nosolobots/robo-com/linus_v1/media/linus_v1_R2_pcb_parts.jpg

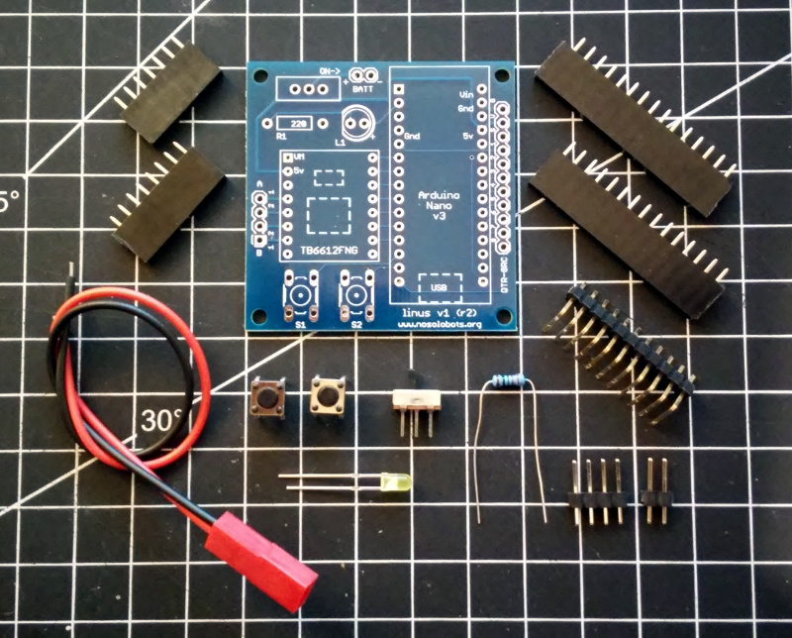
linus_v1/media/linus_v1_R2_pcb_parts.jpg
