nosolobots/robo-com/linus_v1/media/linus_v1_parts.jpg

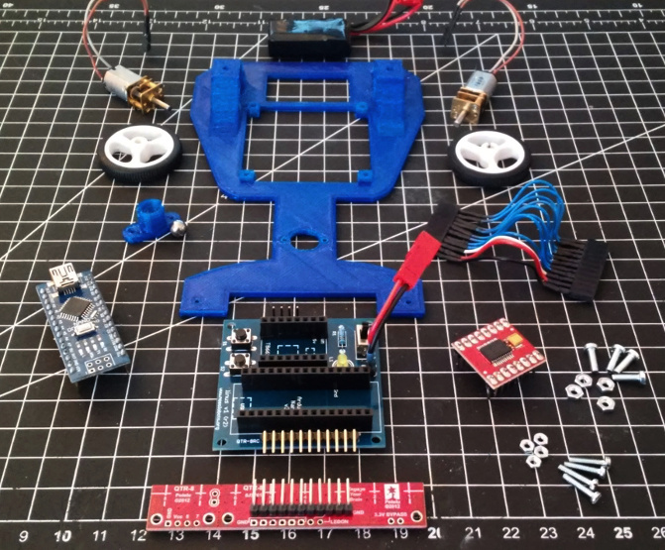
linus_v1/media/linus_v1_parts.jpg
