nosolobots/robo-com/README.md

# robo-com
 
The aim of the project is to create basic robotic kits for contests and competitions. 
 
Currently, there are two kits in progress: 
 
> **linus_v1** a *line follower* robot  
> **taurus_v1** a *mini sumo* robot
