nosolobots/robo-com/taurus_v1/README.md

### *taurus_v1* files repository

- **eagle/** PCB eagle files (sch brd)
- **fritzing/** Fritzing electric diagram
- **3D/** .STL .GCODE and SketchUp 3D model files
- **sketck/** Arduino sketch file
- **media/** Prototypes pictures&videos
