nosolobots/robo-com/taurus_v1/sketch/README.md

### *taurus_v1* Arduino sketches repository
