nosolobots/robo-com/taurus_v1/eagle/README.md

### *taurus_v1* PCB eagle files repository
