nosolobots/robo-com/linus_v1/doc/README.md

## linus_v1 docs repository

- Partlist
- PCB scheme
