nosolobots/robo-com/linus_v1/media/linus_v1_proto.jpg

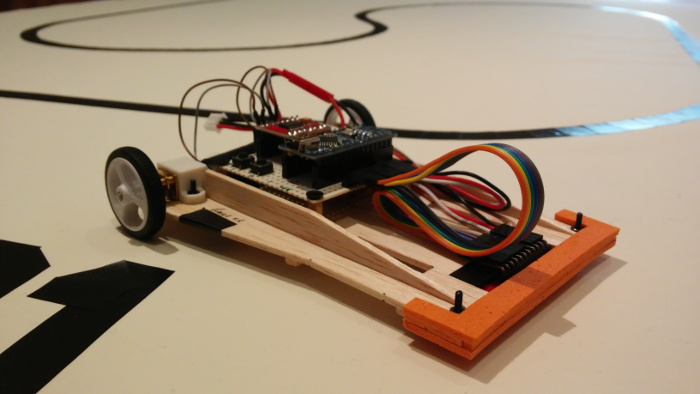
linus_v1/media/linus_v1_proto.jpg
