nosolobots/robo-com/linus_v1/media/linus_v1_R2_bb.jpg

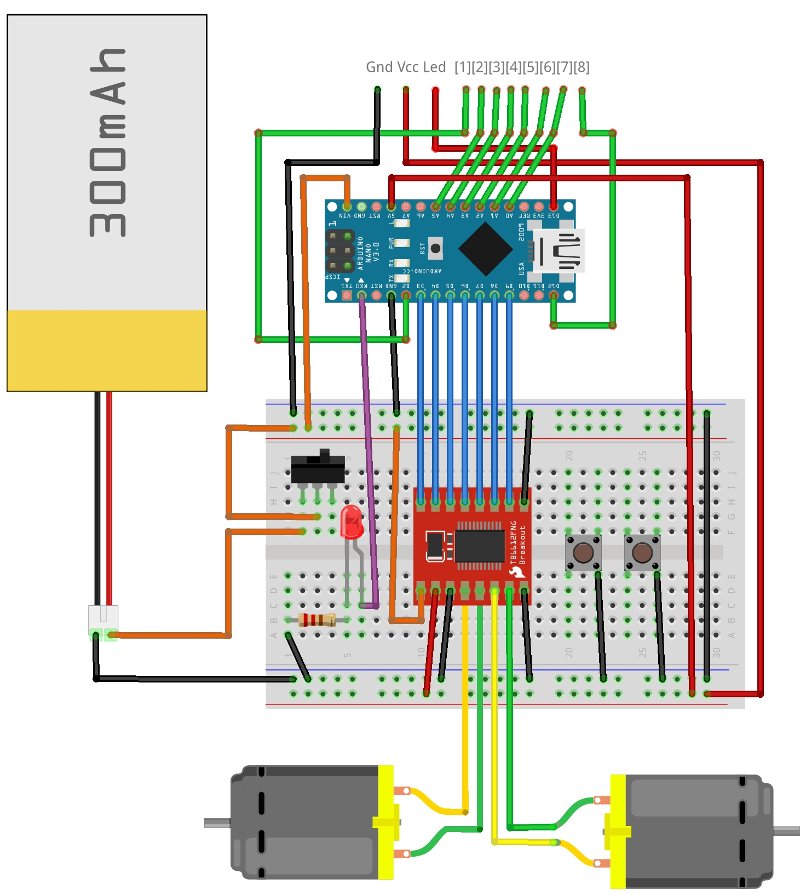
linus_v1/media/linus_v1_R2_bb.jpg
