nosolobots/robo-com/linus_v1/media/linus_v1_R2_EAGLE_brd.png

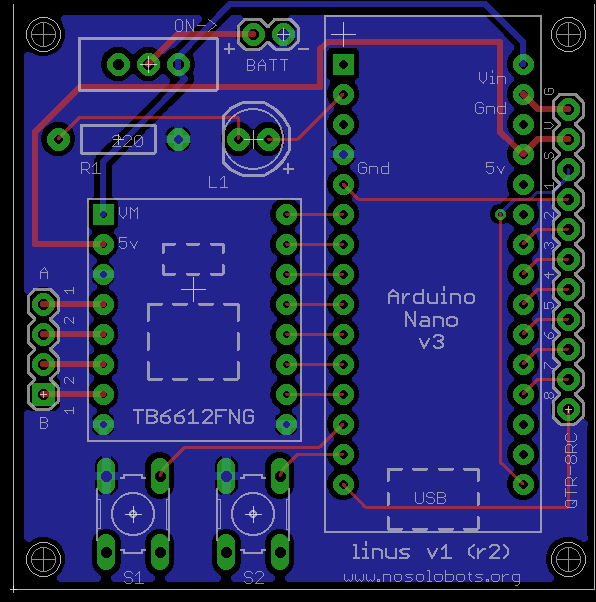
linus_v1/media/linus_v1_R2_EAGLE_brd.png
