nosolobots/robo-com/linus_v1/media/linus_v1_R2_EAGLE_sch.png

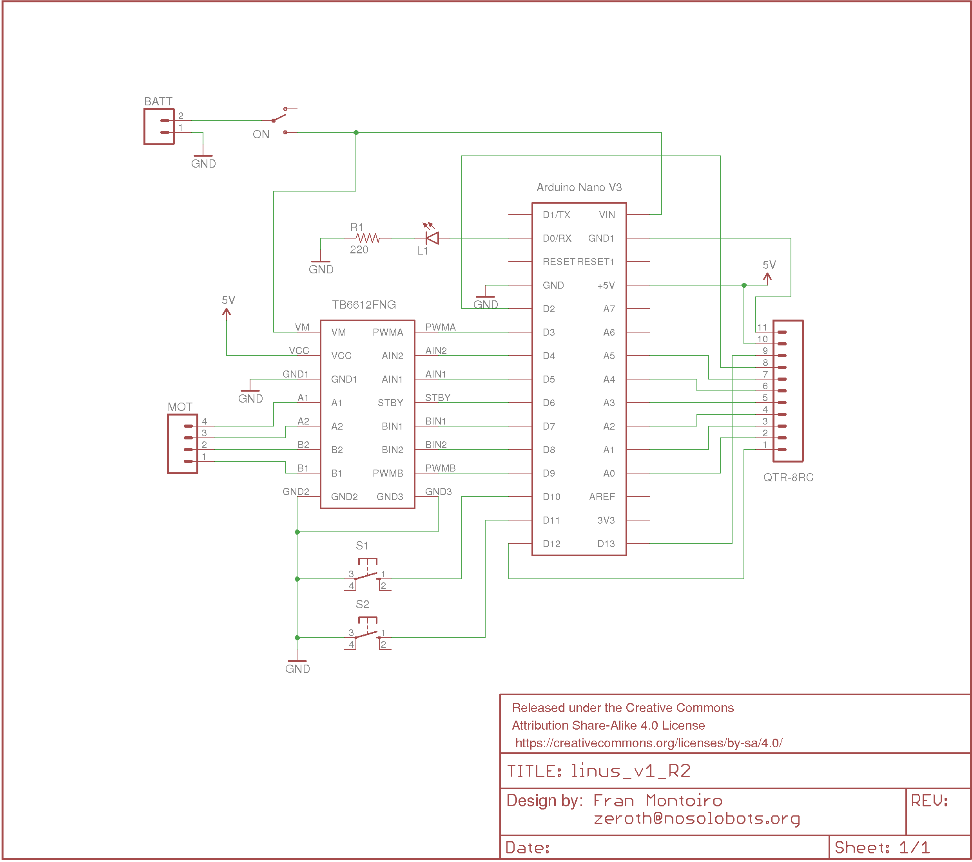
linus_v1/media/linus_v1_R2_EAGLE_sch.png
