nosolobots/robo-com/linus_v1/media/linus_v1_R2_placa.jpg

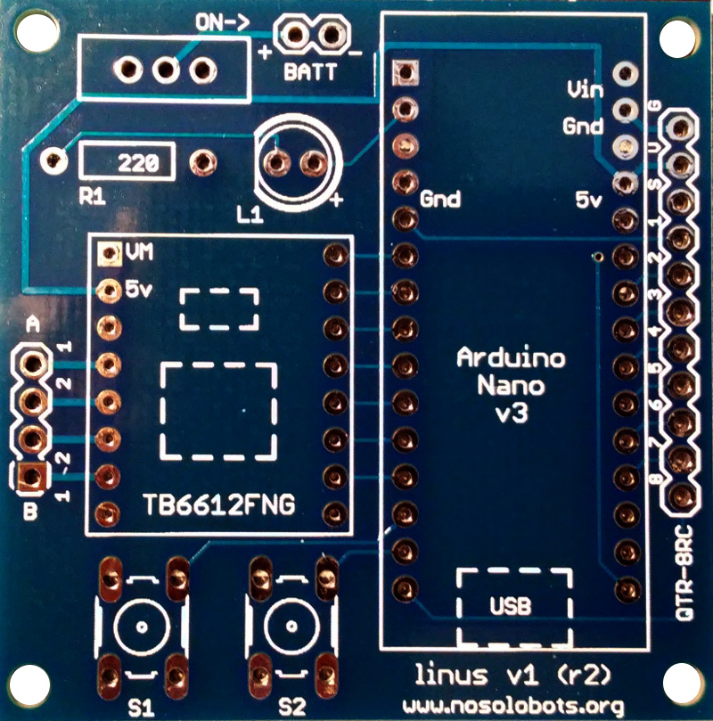
linus_v1/media/linus_v1_R2_placa.jpg
