nosolobots/robo-com/taurus_v1/media/taurus_v1.jpg

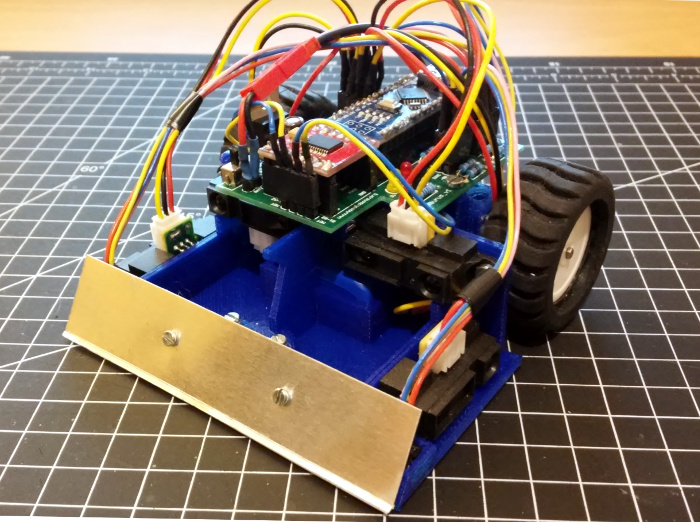
taurus_v1/media/taurus_v1.jpg
