nosolobots/robo-com/taurus_v1/media/taurus_v1_bb.jpg

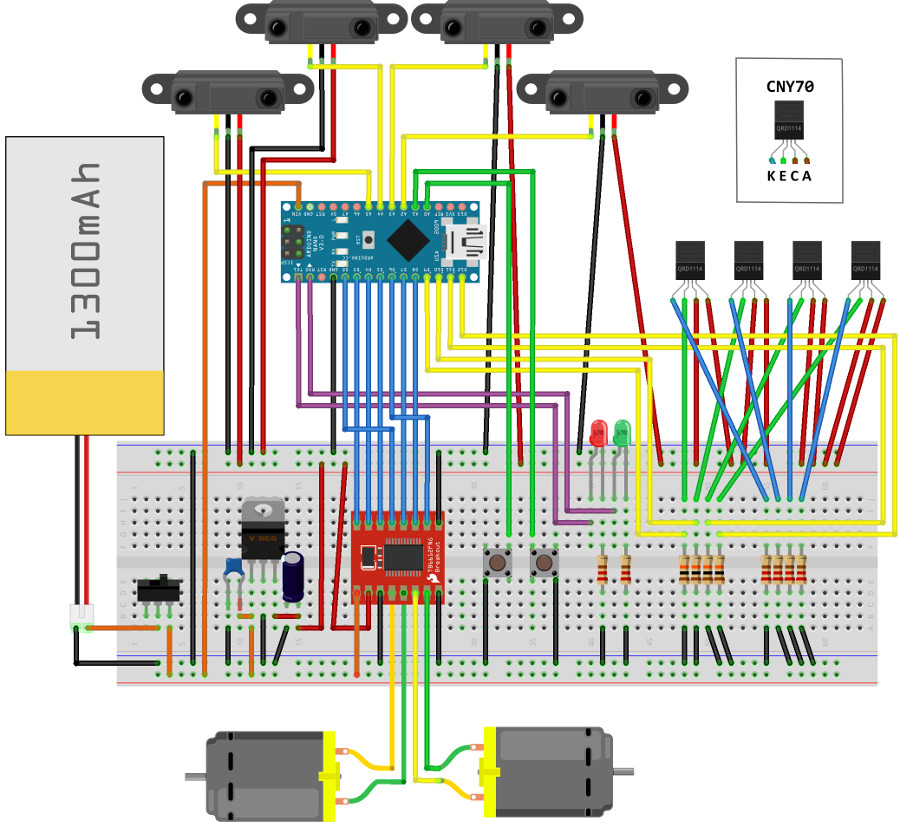
taurus_v1/media/taurus_v1_bb.jpg
