nosolobots/robo-com/taurus_v1/media/taurus_v1_brd.png

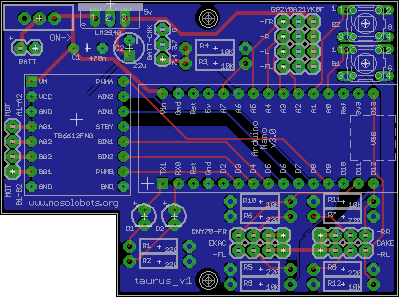
taurus_v1/media/taurus_v1_brd.png
