nosolobots/robo-com/taurus_v1/media/taurus_v1_chasis.jpg

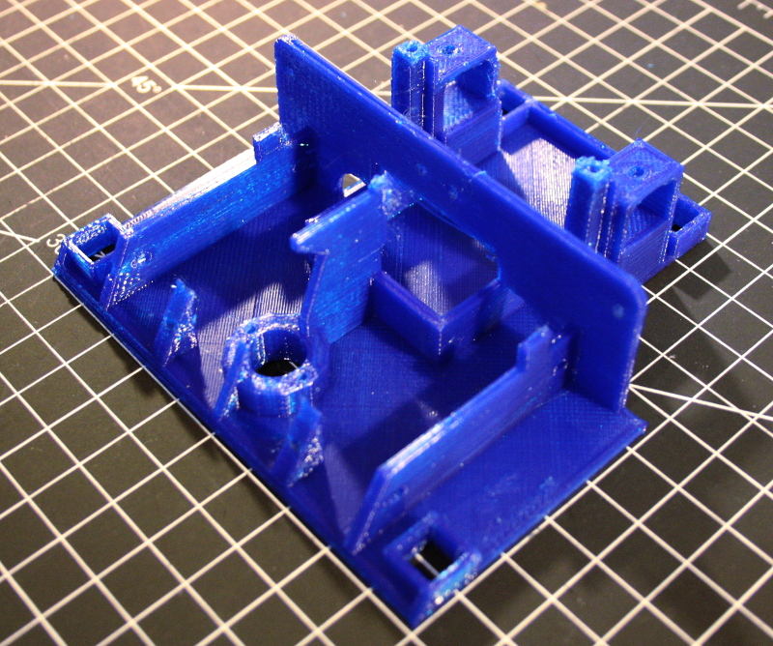
taurus_v1/media/taurus_v1_chasis.jpg
