nosolobots/robo-com/taurus_v1/media/taurus_v1_pcb.jpg

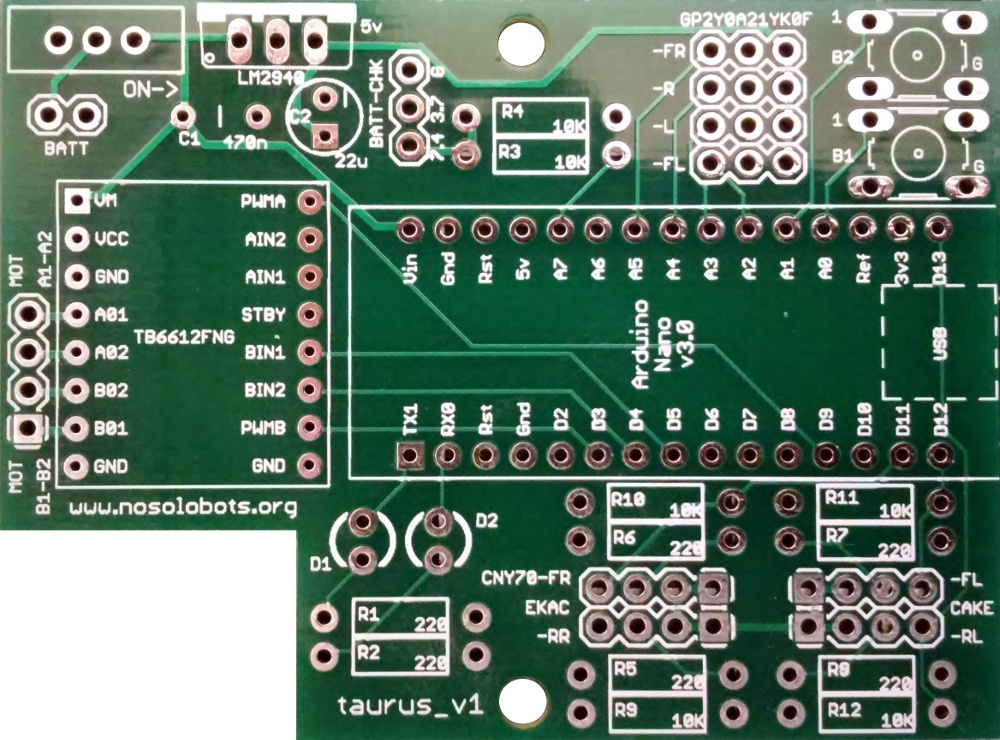
taurus_v1/media/taurus_v1_pcb.jpg
