nosolobots/robo-com/taurus_v1/media/taurus_v1_sch.png

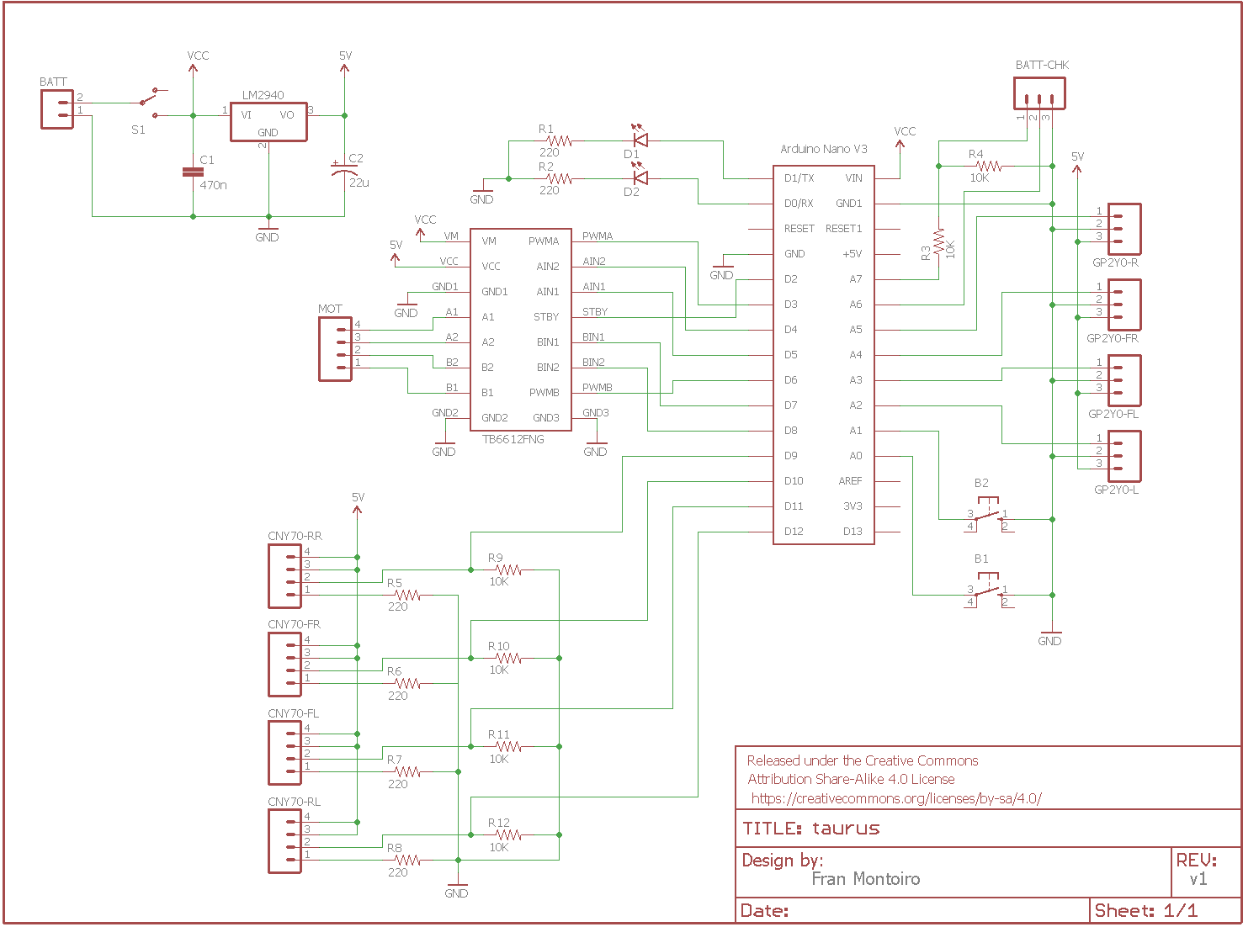
taurus_v1/media/taurus_v1_sch.png
