nosolobots/robo-com/linus_v1/3D/linus_v1_r4.stl

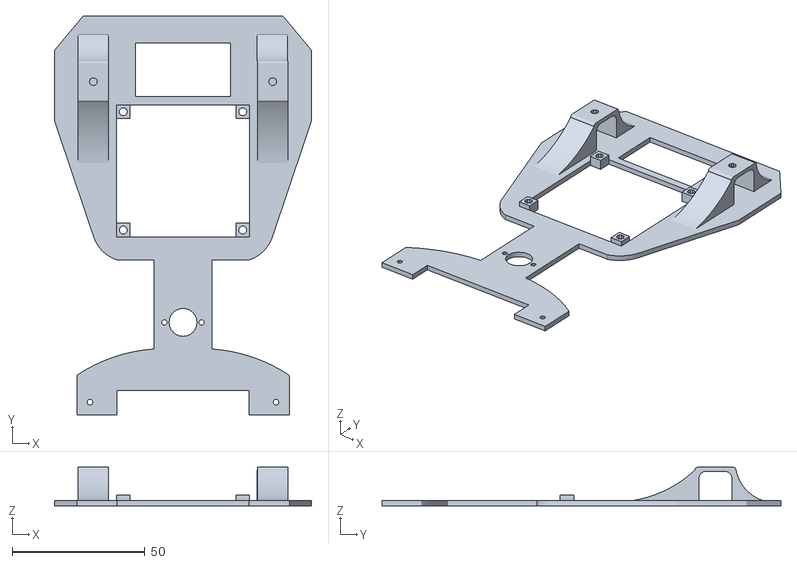
[picture p20: CAD file, 2017-03-30]
linus_v1/3D/linus_v1_r4.stl
96.7 x 150.1 x 14.5
