nosolobots/robo-com/taurus_v1/3D/taurus_v1_r2.stl

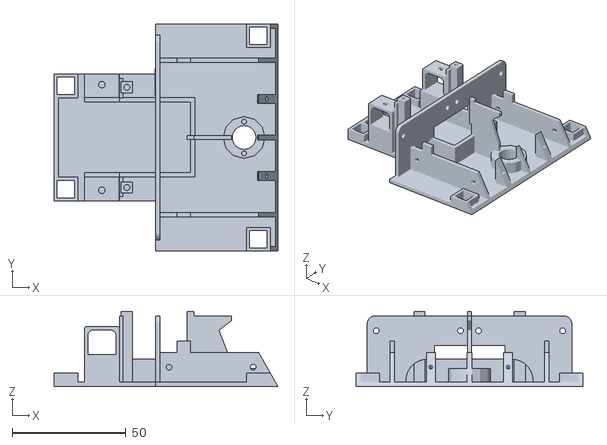
[picture p21: CAD file, 2017-03-30]
taurus_v1/3D/taurus_v1_r2.stl
98.4 x 99.9 x 33.0
