nosolobots/robo-com/taurus_v1/3D/BallCaster_6mm.stl

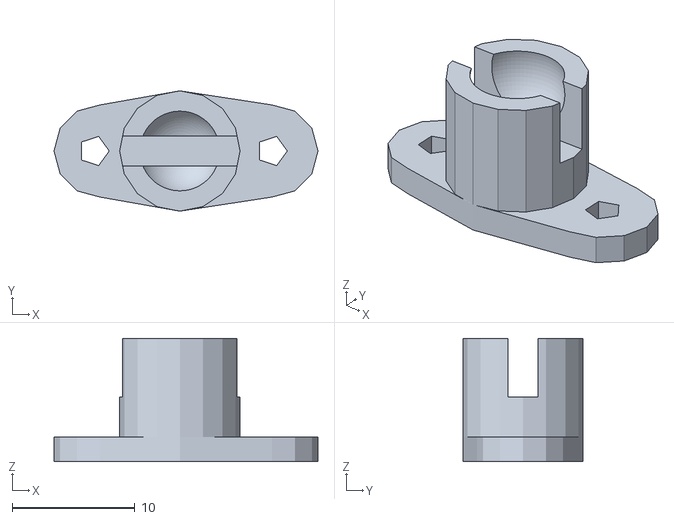
[picture p22: CAD file, 2017-03-30]
taurus_v1/3D/BallCaster_6mm.stl
21.5 x 9.80 x 10.0
