nosolobots/robo-com/(list of files, cad)

Other CAD files:
linus_v1/3D/linus_v1_r4.skp
taurus_v1/3D/taurus_v1_r2.skp
