nosolobots/robo-com/(list of files, drawings)

Other design files:
linus_v1/fritzing/linus_v1_R2.fzz
taurus_v1/fritzing/taurus_v1.fzz
