nosolobots/robo-com/taurus_v1/eagle/taurus_v1.brd

## EAGLE design taurus_v1/eagle/taurus_v1.brd (2017-03-30)

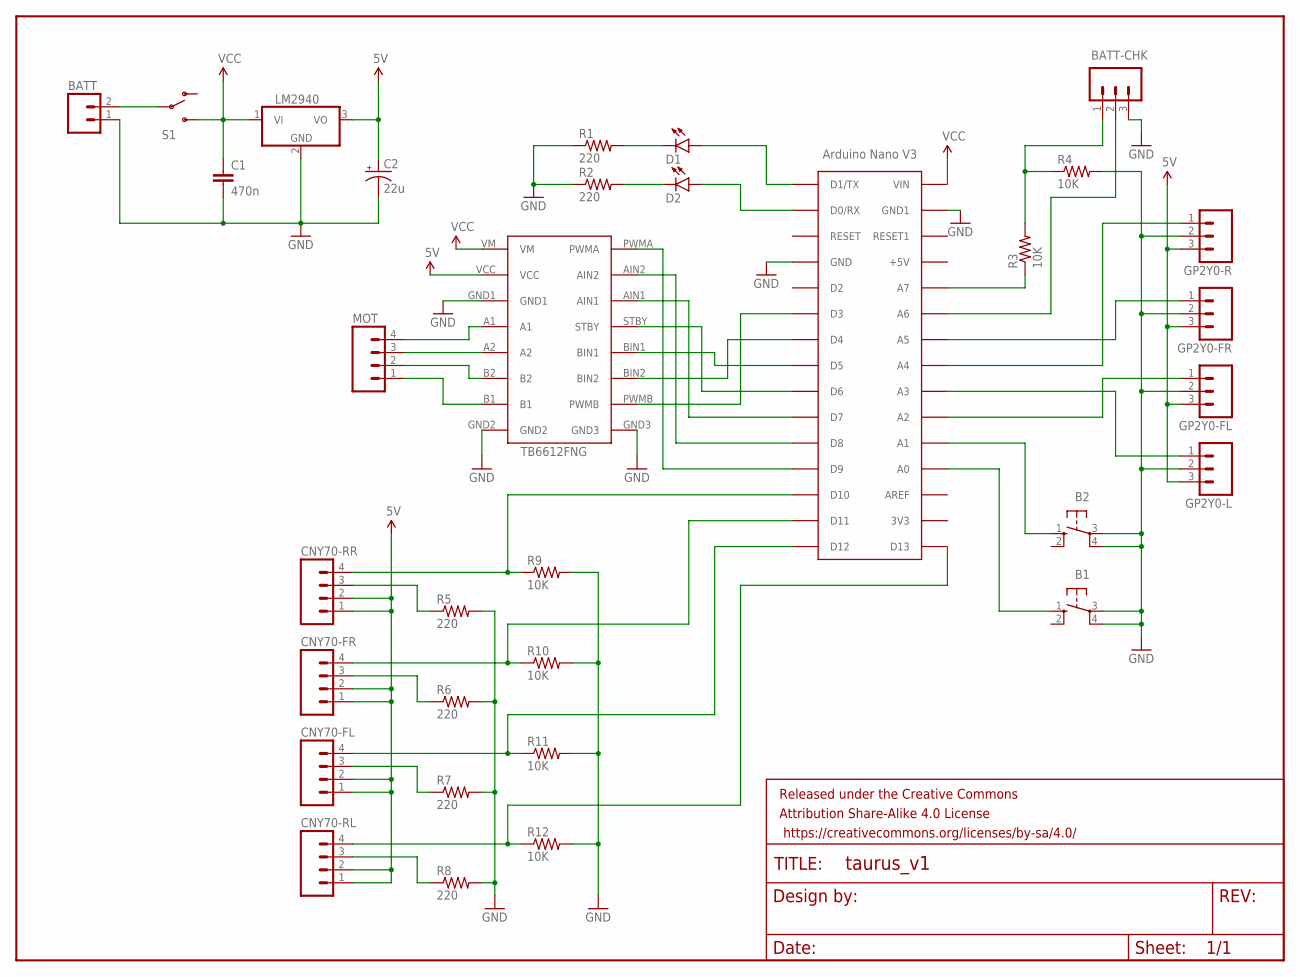
[picture p23: schematic taurus_v1.sch]

Parts:
B1, B2: 10-XX; B3F-10XX
BATT: M02PTH; 1X02
BATT-CHK: M03PTH; 1X03
C1: 470n; CAP-PTH-5MM
C2: 22u; CPOL-RADIAL-10UF-25V
CNY70-FL, CNY70-FR, CNY70-RL, CNY70-RR: M04PTH; 1X04
D1, D2: LED3MM
FRAME1: FRAME-LETTERNO_PACKAGE; DUMMY
GP2Y0-FL, GP2Y0-FR, GP2Y0-L, GP2Y0-R: M03PTH; 1X03
LM2940: 7805TV; TO220V
MOT: M04PTH; 1X04
R1, R2, R5, R6, R7, R8: 220; AXIAL-0.4
R3, R4, R9, R10, R11, R12: 10K; AXIAL-0.4
S1: SWITCH-SPDTPTH; SWITCH-SPDT
TB1: TB6612FNG
U$1: ARDUINONANO; PDIP-32

Connections:
5V: C2.1 (+), CNY70-FL.1, CNY70-FL.2, CNY70-FR.1, CNY70-FR.2, CNY70-RL.1, CNY70-RL.2, CNY70-RR.1, CNY70-RR.2, GP2Y0-FL.3, GP2Y0-FR.3, GP2Y0-L.3, GP2Y0-R.3, LM2940.3 (VO), TB1.VCC
GND: B1.3, B1.4 (P1), B2.3, B2.4 (P1), BATT.1, BATT-CHK.3, C1.2, C2.2 (-), GP2Y0-FL.2, GP2Y0-FR.2, GP2Y0-L.2, GP2Y0-R.2, LM2940.2 (GND), R1.P$1 (1), R2.P$1 (1), R4.P$2 (2), R5.P$2 (2), R6.P$2 (2), R7.P$2 (2), R8.P$2 (2), R9.P$2 (2), R10.P$2 (2), R11.P$2 (2), R12.P$2 (2), TB1.GND1, TB1.GND2, TB1.GND3, U$1.GND, U$1.GND1
unnamed: TB1.PWMA, U$1.D9
unnamed: TB1.AIN2, U$1.D8
unnamed: TB1.AIN1, U$1.D7
unnamed: TB1.STBY, U$1.D6
unnamed: TB1.BIN1, U$1.D5
unnamed: TB1.BIN2, U$1.D4
unnamed: TB1.PWMB, U$1.D3
unnamed: D1.K (C), R1.P$2 (2)
unnamed: D2.K (C), R2.P$2 (2)
unnamed: D2.A, U$1.D0/RX
unnamed: D1.A, U$1.D1/TX
unnamed: BATT.2, S1.2
unnamed: B1.1 (S), U$1.A7 (A0)
unnamed: B2.1 (S), U$1.A6 (A1)
unnamed: GP2Y0-L.1, U$1.A4 (A3)
unnamed: GP2Y0-R.1, U$1.A3 (A4)
unnamed: GP2Y0-FL.1, U$1.A5 (A2)
unnamed: BATT-CHK.2, U$1.A1 (A6)
unnamed: R3.P$1 (1), U$1.A0 (A7)
unnamed: BATT-CHK.1, R3.P$2 (2), R4.P$1 (1)
unnamed: MOT.4, TB1.A1
unnamed: MOT.3, TB1.A2
unnamed: MOT.2, TB1.B2
unnamed: MOT.1, TB1.B1
unnamed: CNY70-RR.4, R9.P$1 (1), U$1.D10
unnamed: CNY70-RR.3, R5.P$1 (1)
unnamed: CNY70-FR.3, R6.P$1 (1)
unnamed: CNY70-FL.3, R7.P$1 (1)
unnamed: CNY70-RL.3, R8.P$1 (1)
unnamed: CNY70-FR.4, R10.P$1 (1), U$1.D11
unnamed: CNY70-RL.4, R12.P$1 (1), U$1.D13
unnamed: CNY70-FL.4, R11.P$1 (1), U$1.D12
unnamed: GP2Y0-FR.1, U$1.A2 (A5)
VCC: C1.1, LM2940.1 (VI), S1.3 (S), TB1.VM, U$1.VIN

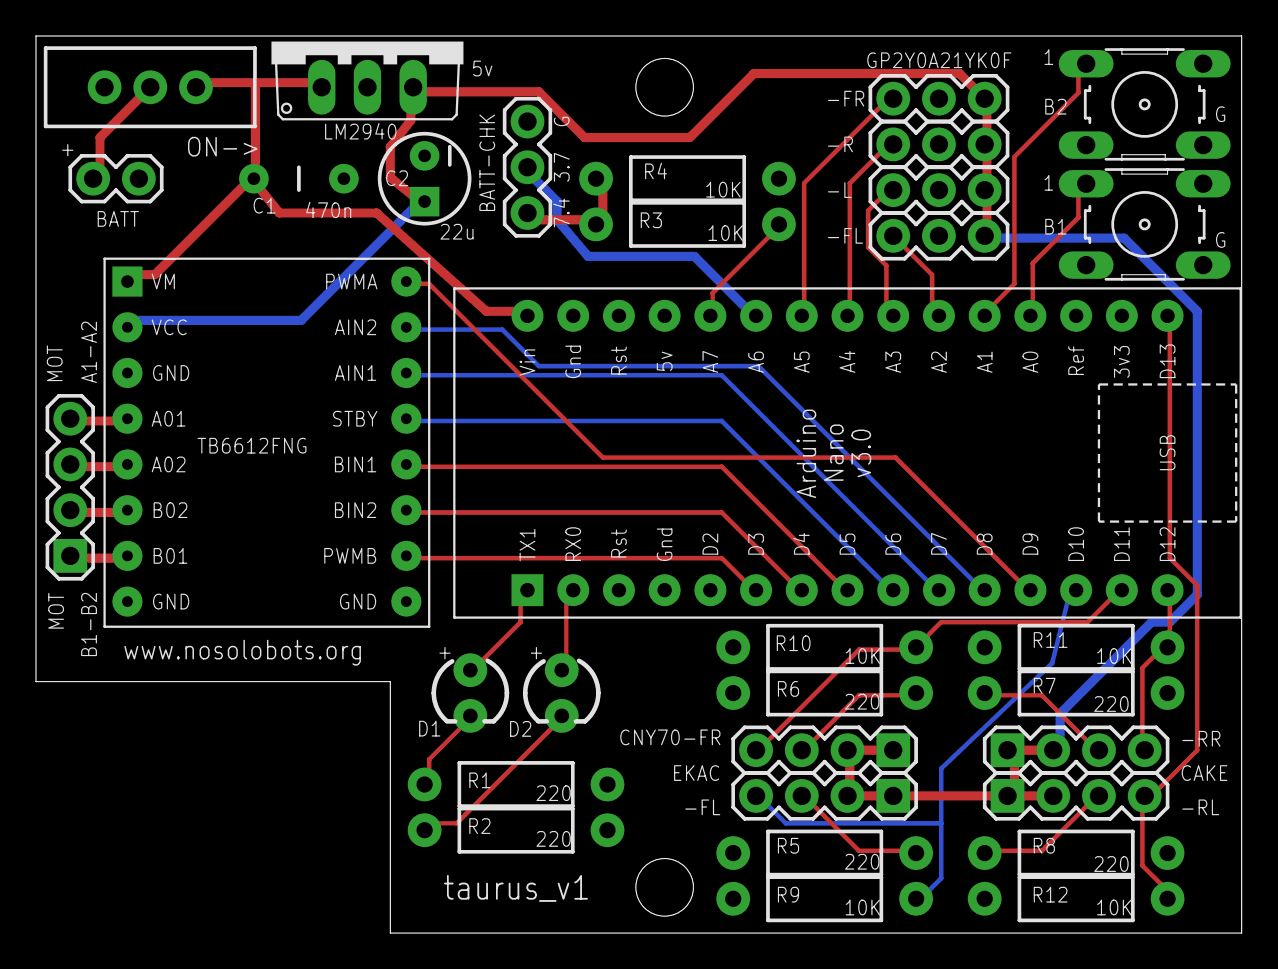
[picture p24: board taurus_v1.brd from above]

Board: 2 copper layers, 67.0 x 49.8 mm, 34 parts (0 on the bottom side), 36 nets.
