nosolobots/robo-com/linus_v1/eagle/linus_v1_R2.brd

## EAGLE design linus_v1/eagle/linus_v1_R2.brd (2017-03-30)

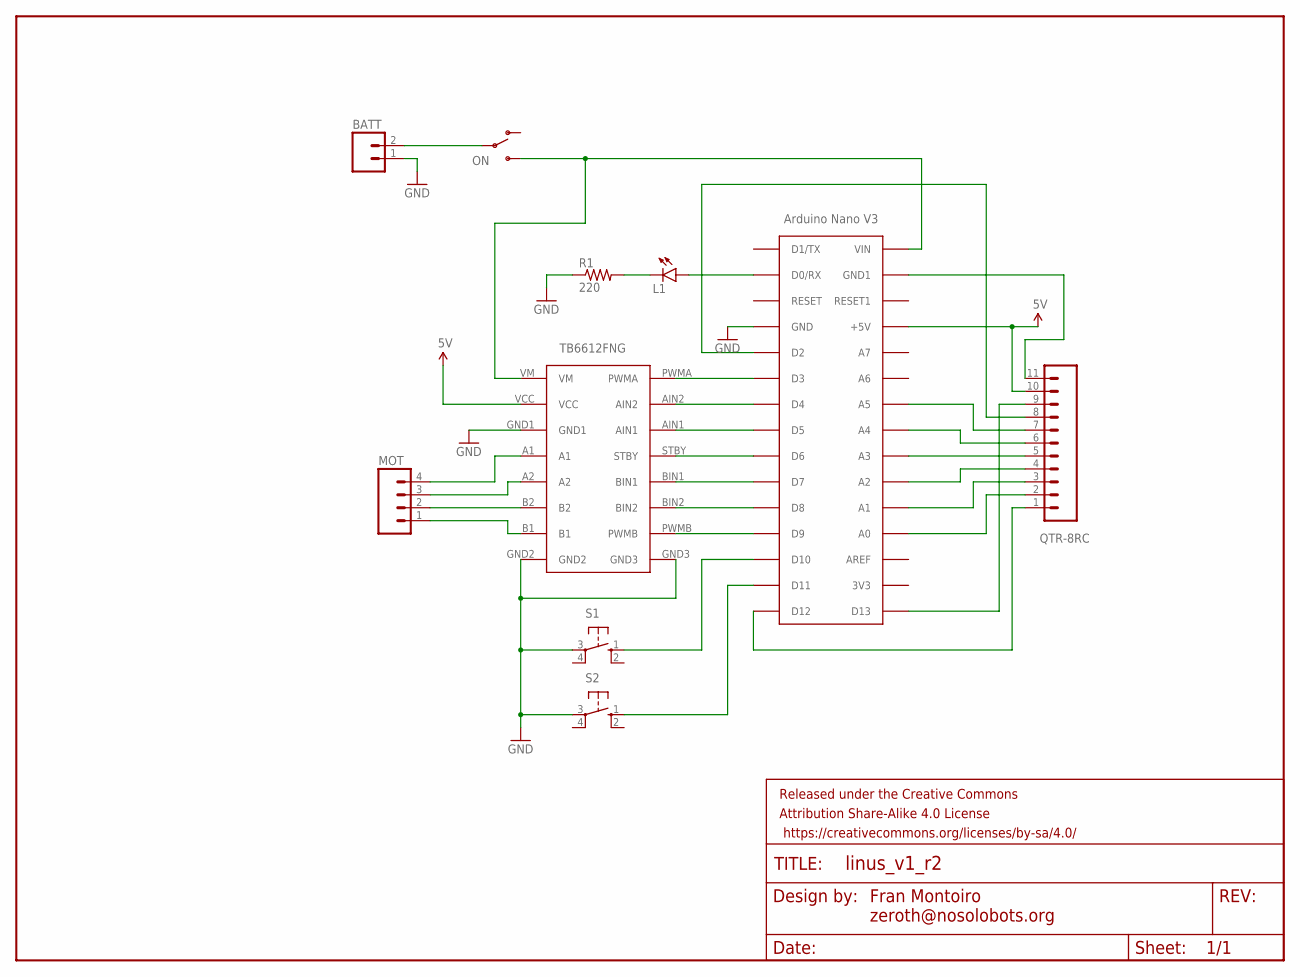
[picture p25: schematic linus_v1_R2.sch]

Parts:
BATT: M02PTH; 1X02
FRAME1: FRAME-LETTERNO_PACKAGE; DUMMY
L1: LED5MM
MOT: M04PTH; 1X04
ON: SWITCH-SPDTPTH; SWITCH-SPDT
QTR-8RC: M11PTH; 1X11
R1: 220; AXIAL-0.4
S1, S2: 10-XX; B3F-10XX
TB1: TB6612FNG
U$1: ARDUINONANO; PDIP-32

Connections:
5V: QTR-8RC.10, TB1.VCC, U$1.+5V
GND: BATT.1, R1.P$1 (1), S1.3, S2.3, TB1.GND1, TB1.GND2, TB1.GND3, U$1.GND
unnamed: MOT.4, TB1.A1
unnamed: MOT.3, TB1.A2
unnamed: MOT.2, TB1.B2
unnamed: MOT.1, TB1.B1
unnamed: QTR-8RC.8, U$1.D2
unnamed: S1.1 (S), U$1.D10
unnamed: S2.1 (S), U$1.D11
unnamed: TB1.PWMA, U$1.D3
unnamed: TB1.AIN2, U$1.D4
unnamed: TB1.AIN1, U$1.D5
unnamed: TB1.STBY, U$1.D6
unnamed: TB1.BIN1, U$1.D7
unnamed: TB1.BIN2, U$1.D8
unnamed: TB1.PWMB, U$1.D9
unnamed: QTR-8RC.7, U$1.A2 (A5)
unnamed: QTR-8RC.6, U$1.A3 (A4)
unnamed: QTR-8RC.5, U$1.A4 (A3)
unnamed: QTR-8RC.4, U$1.A5 (A2)
unnamed: QTR-8RC.3, U$1.A6 (A1)
unnamed: QTR-8RC.2, U$1.A7 (A0)
unnamed: QTR-8RC.1, U$1.D12
unnamed: ON.3 (S), TB1.VM, U$1.VIN
unnamed: L1.K (C), R1.P$2 (2)
unnamed: QTR-8RC.9, U$1.D13
unnamed: L1.A, U$1.D0/RX
unnamed: QTR-8RC.11, U$1.GND1
V+: BATT.2, ON.2

Notes on the sheet:
Fran Montoiro zeroth@nosolobots.org

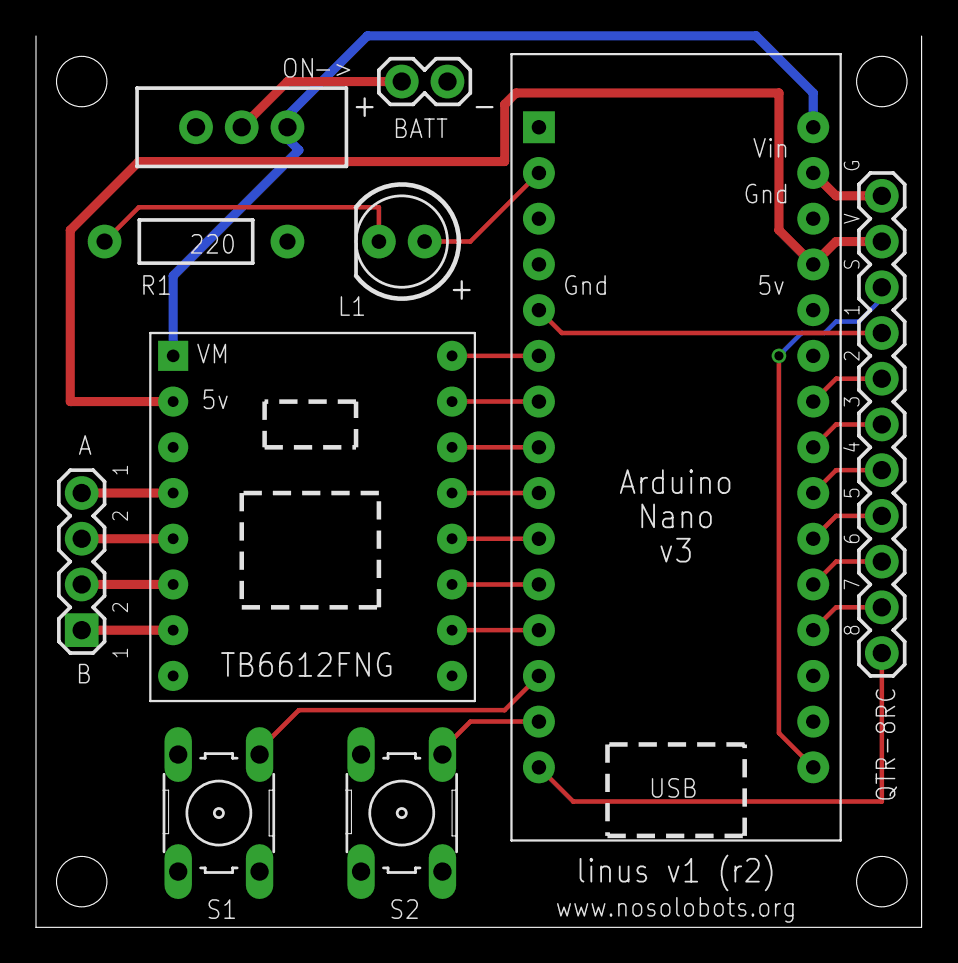
[picture p26: board linus_v1_R2.brd from above]

Board: 2 copper layers, 49.2 x 49.5 mm, 11 parts (0 on the bottom side), 29 nets.
